JimHeaney/ultralogger/README.md

# Ultralogger

## Overview

The Ultralogger is a compact and lightweight data logger, small enough to fit snugly in a 17mm body tube, for use on both low and high power rockets. The Ultralogger is capable of measuring altitudes through 100,000 feet (30,500 meters), acceleration up to 200g, and temperature between -40 and 185 Farenheit (-40 to 85 Celsius). 

Using the Micro USB port, the integrated battery can be charged, settings can be configured, and data can be downloaded. 

USB-Configurable Settings Include:
* Select between metric and Imperial units
* Adjustable logging rate, up to 20Hz (future software updates can push this up to 50Hz)
* Set altitude mode to absolute (ASL) or relative (AGL of launch pad, automatically acquired)
* Variable liftoff detection, using customizable acceleration and/or altitude thresholds. Both can also be disabled to auto-start recording on powerup.

Settings can also be changed after flight but before downloading the data if you forgot to configure something before launch, such as swapping the units. 

At the maximum recording speed of 20Hz, the Ultralogger can record for up to 13 minutes. Automatic liftoff and landing detection maximize recording time and help preserve battery life.

Data is recorded in solid-state memory that will last more than 40 years without power. Data can be downloaded using any serial terminal software, allowing compatability with all major computer operating systems and many phones.

For more information on the Ultralogger, please see the [wiki on GitHub](https://github.com/JimHeaney/ultralogger/wiki).

## Photos & Media



## Current Release
There are no stable, public releases of the Ultralogger at this time. 

## Current State
Version 1.1 of the Ultralogger is currently undergoing flight testing and verification. Development has begun on incremental iimprovement Version 1.2.

## Featured In...

[Microchip Makes](https://www.linkedin.com/feed/update/urn:li:activity:7003073035171733504/)

## Support Me
You can also buy me a coffee [here](https://www.buymeacoffee.com/jimheaney)!

## License
This project is licensed under the Creative Commons 4.0 Attribution-NonCommercial-ShareAlike. For more information, click [here](https://creativecommons.org/licenses/by-nc-sa/4.0/).

If you want to use this project under a different license, please contact me.
