JimHeaney/ultralogger/SCH_Ultralogger Schematic_2023-01-02.pdf

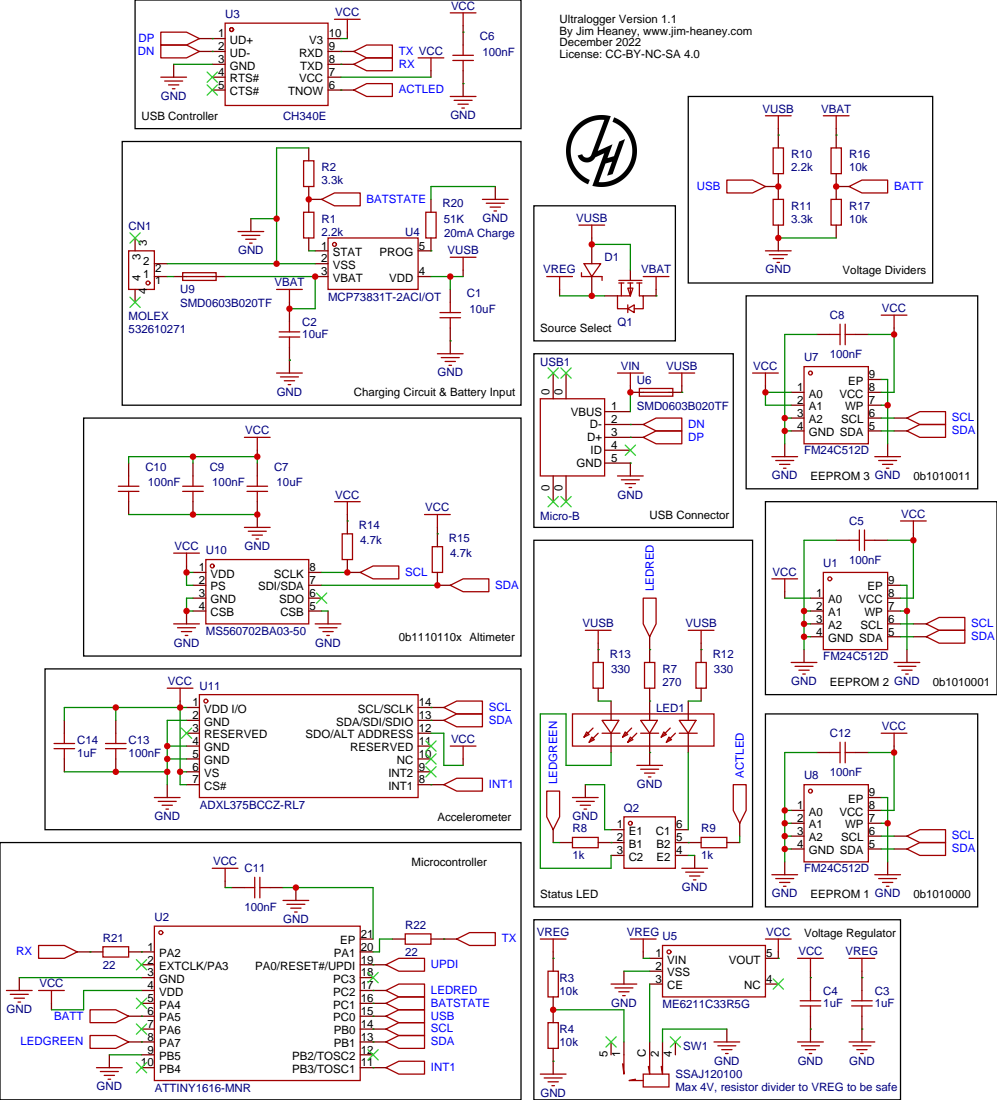
[picture p1: page 1]

Ultralogger Version 1.1
By Jim Heaney, www.jim-heaney.com
December 2022
License: CC-BY-NC-SA 4.0

Charging Circuit & Battery Input

NC 10 RESERVED 11 SDO/ALT ADDRESS 12 SDA/SDI/SDIO 13 SCL/SCLK 14

GND
Max 4V, resistor divider to VREG to be safe
